dineshannayya/8bit_dac/docs/source/_static/8bit_DAC_Implementation.pptx

Switch

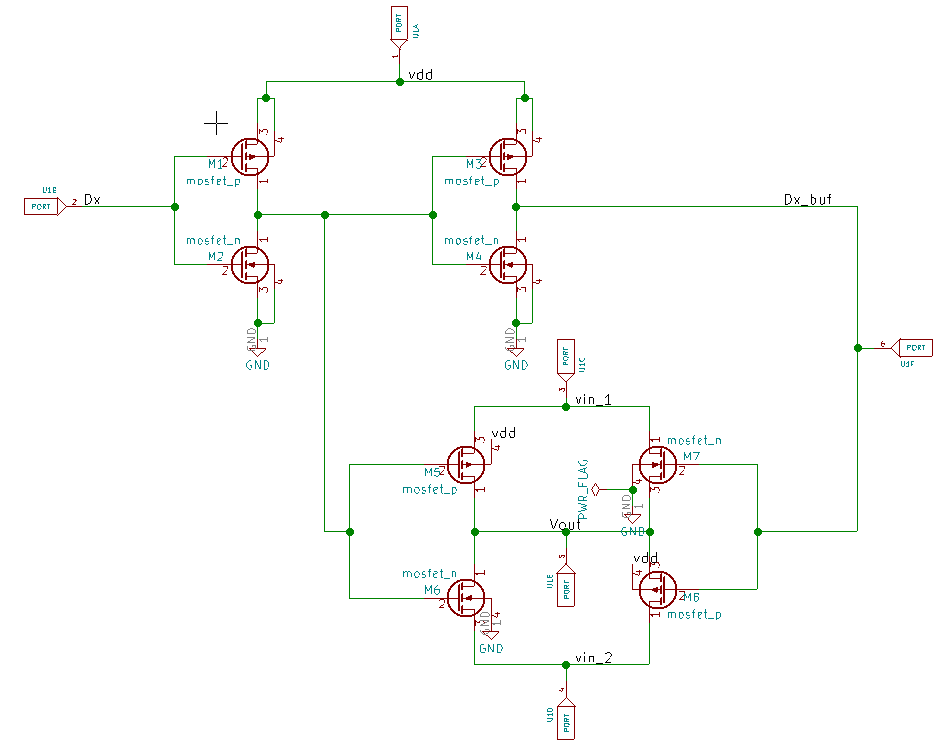
[picture p12: figure]

## Slide 2

Switch 2n

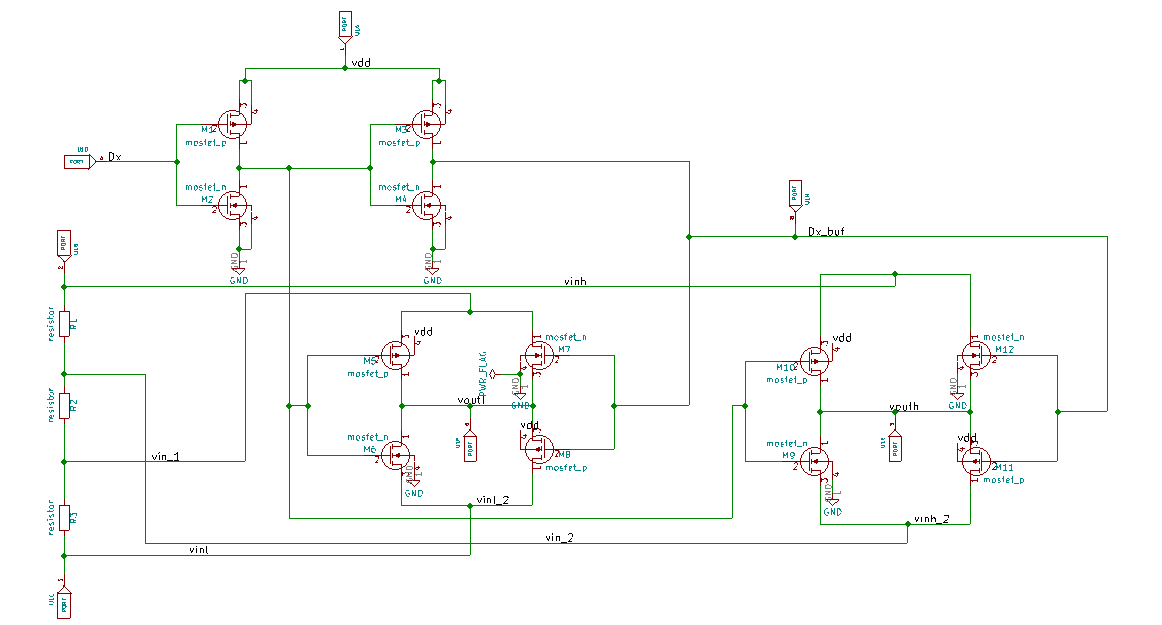
[picture p13: figure]

## Slide 3

2bit DAC

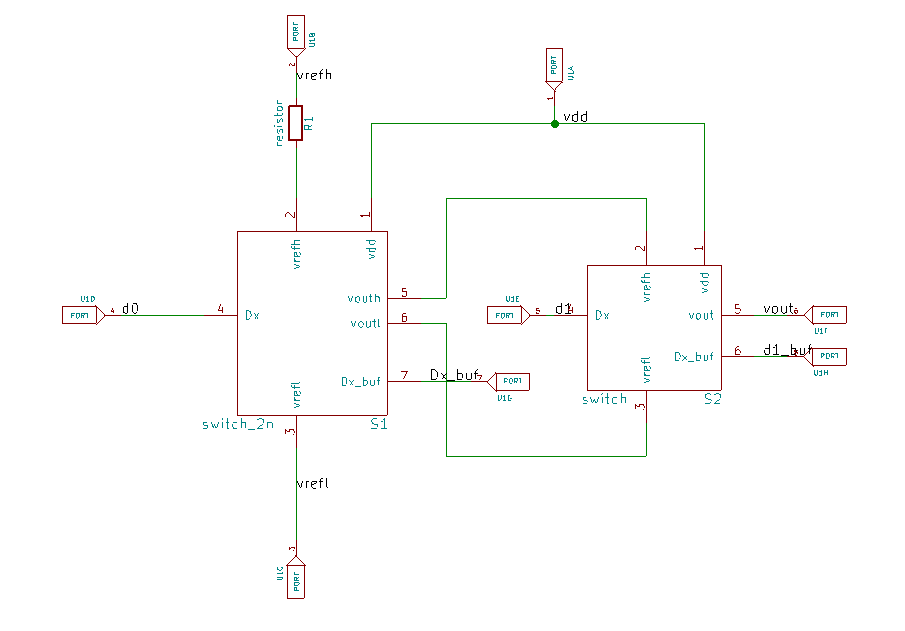
[picture p14: figure]

## Slide 4

3 bit DAC

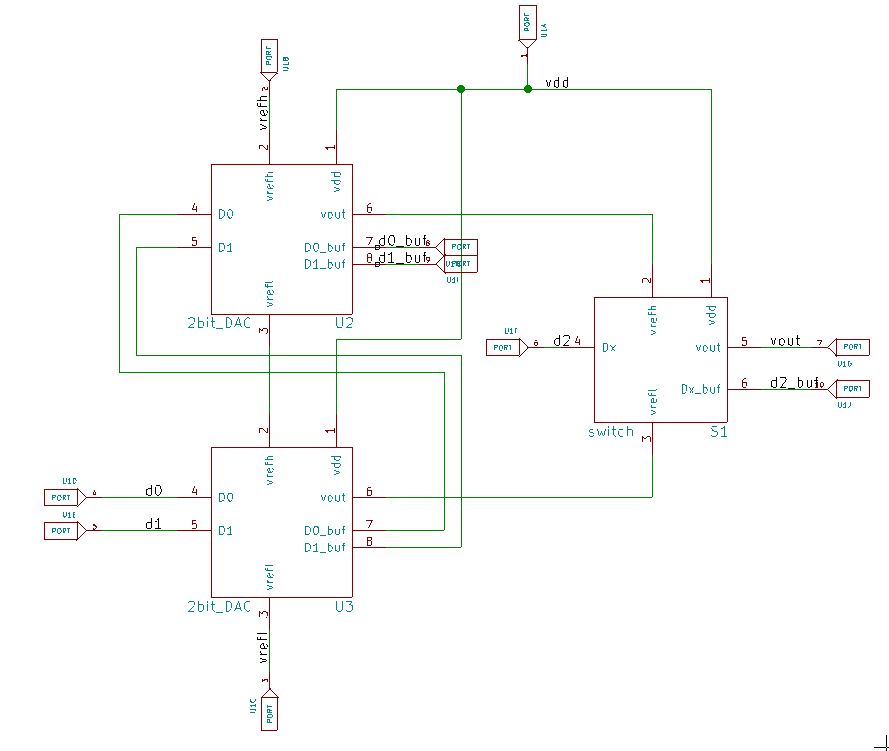
[picture p15: figure]

## Slide 5

4 bit DAC

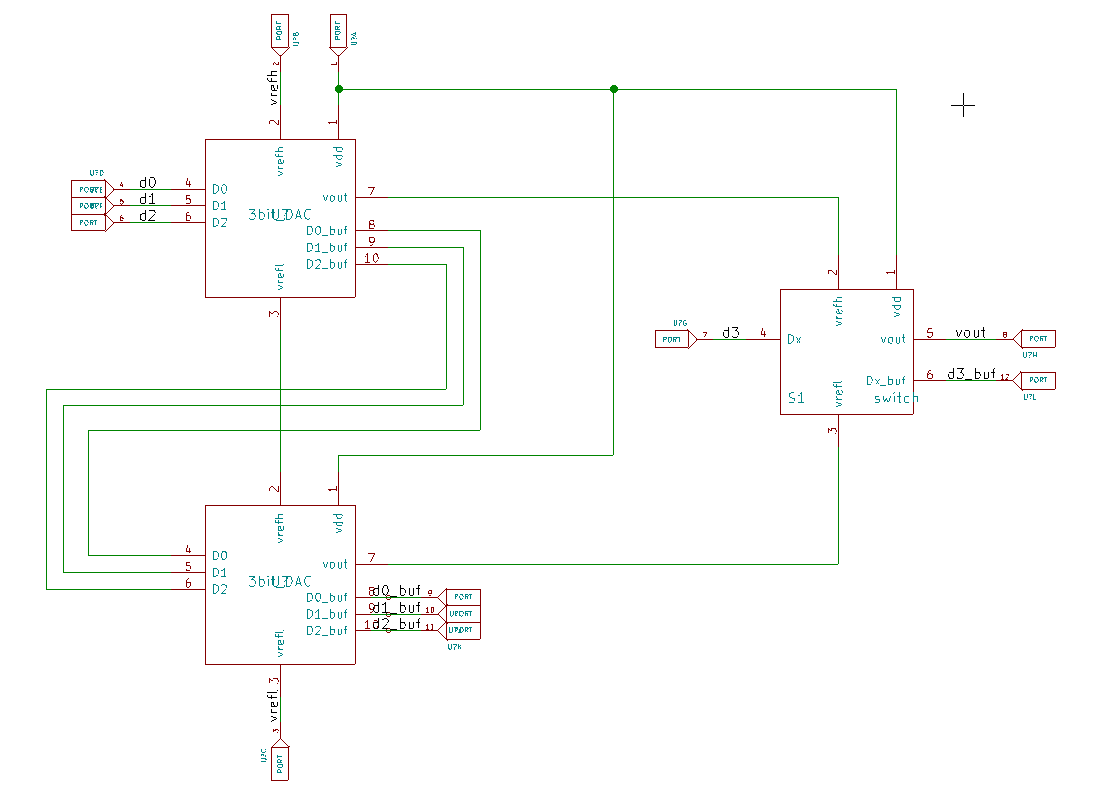
[picture p16: figure]
