dineshannayya/8bit_dac/schematics/switch_2n/switch_2n.cir

* /home/dinesha/workarea/opencore/git/8bit_dac/schematics/switch_2n/switch_2n.cir

* EESchema Netlist Version 1.1 (Spice format) creation date: Sun 30 Apr 2023 10:32:47 PM IST

* To exclude a component from the Spice Netlist add [Spice_Netlist_Enabled] user FIELD set to: N
* To reorder the component spice node sequence add [Spice_Node_Sequence] user FIELD and define sequence: 2,1,0

* Sheet Name: /
M3  /Dx_buf Net-_M1-Pad1_ /vdd /vdd mosfet_p		
M4  /Dx_buf Net-_M1-Pad1_ GND GND mosfet_n		
M1  Net-_M1-Pad1_ /Dx /vdd /vdd mosfet_p		
M2  Net-_M1-Pad1_ /Dx GND GND mosfet_n		
M6  /voutl Net-_M1-Pad1_ /vinl GND mosfet_n		
M5  /voutl Net-_M1-Pad1_ /vin_1 /vdd mosfet_p		
M7  /vin_1 /Dx_buf /voutl GND mosfet_n		
M8  /vinl /Dx_buf /voutl /vdd mosfet_p		
U1  /vdd /vinh /vinl /Dx /vouth /voutl /Dx_buf PORT		
M10  /vouth Net-_M1-Pad1_ /vinh /vdd mosfet_p		
M11  /vin_2 /Dx_buf /vouth /vdd mosfet_p		
M9  /vouth Net-_M1-Pad1_ /vin_2 GND mosfet_n		
M12  /vinh /Dx_buf /vouth GND mosfet_n		
R1  /vinh /vin_2 resistor		
R2  /vin_2 /vin_1 resistor		
R3  /vin_1 /vinl resistor		

.end
