dineshannayya/8bit_dac/eSimLibrary/2bit_DAC/2bit_DAC.sch

## KiCad design eSimLibrary/2bit_DAC/2bit_DAC.sch (2023-04-30)

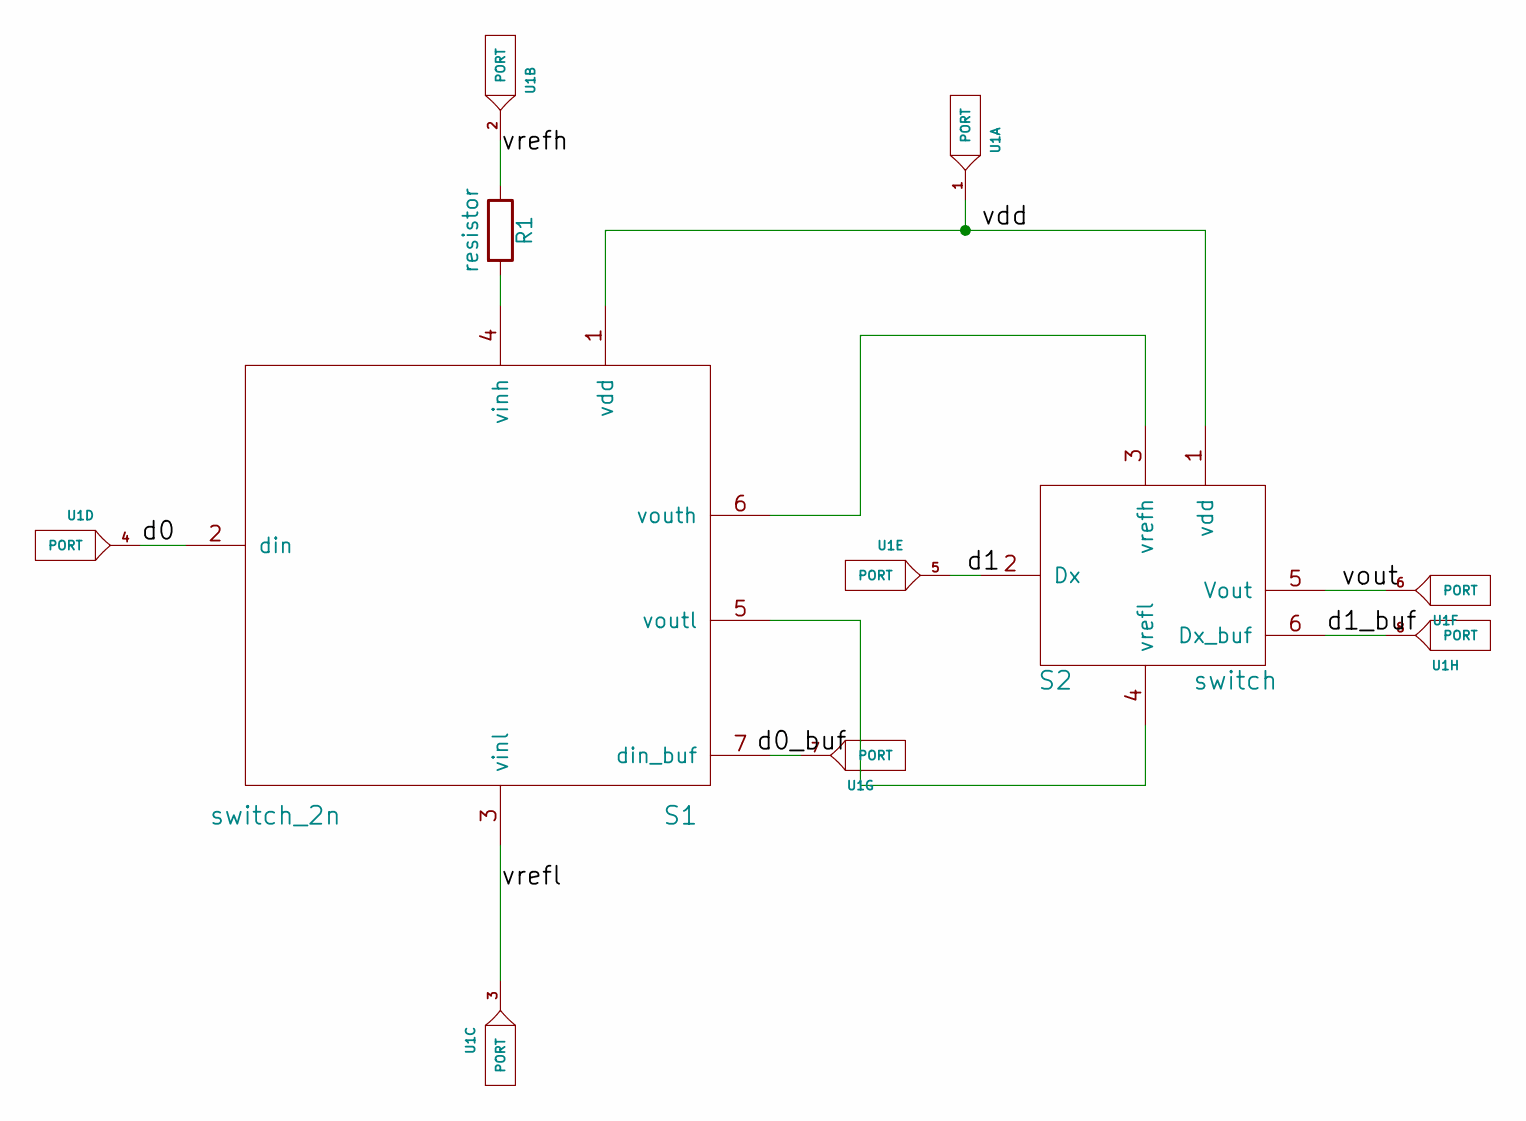
[picture p17: schematic 2bit_DAC.sch]

Parts:
R1: resistor
S1: switch_2n
S2: switch
U1: PORT

Connections:
unnamed: R1.2, S1.4 (vinh)
unnamed: S1.5 (voutl), S2.4 (vrefl)
unnamed: S1.6 (vouth), S2.3 (vrefh)
unnamed: S1.7 (din_buf), U1.7
d0: S1.2 (din), U1.4
d1: S2.2 (Dx), U1.5
d1_buf: S2.6 (Dx_buf), U1.8
vdd: S1.1 (vdd), S2.1 (vdd), U1.1
vout: S2.5 (Vout), U1.6
vrefh: R1.1, U1.2
vrefl: S1.3 (vinl), U1.3
