dineshannayya/8bit_dac/eSimLibrary/3bit_DAC/3bit_DAC.sch

## KiCad design eSimLibrary/3bit_DAC/3bit_DAC.sch (2023-04-30)

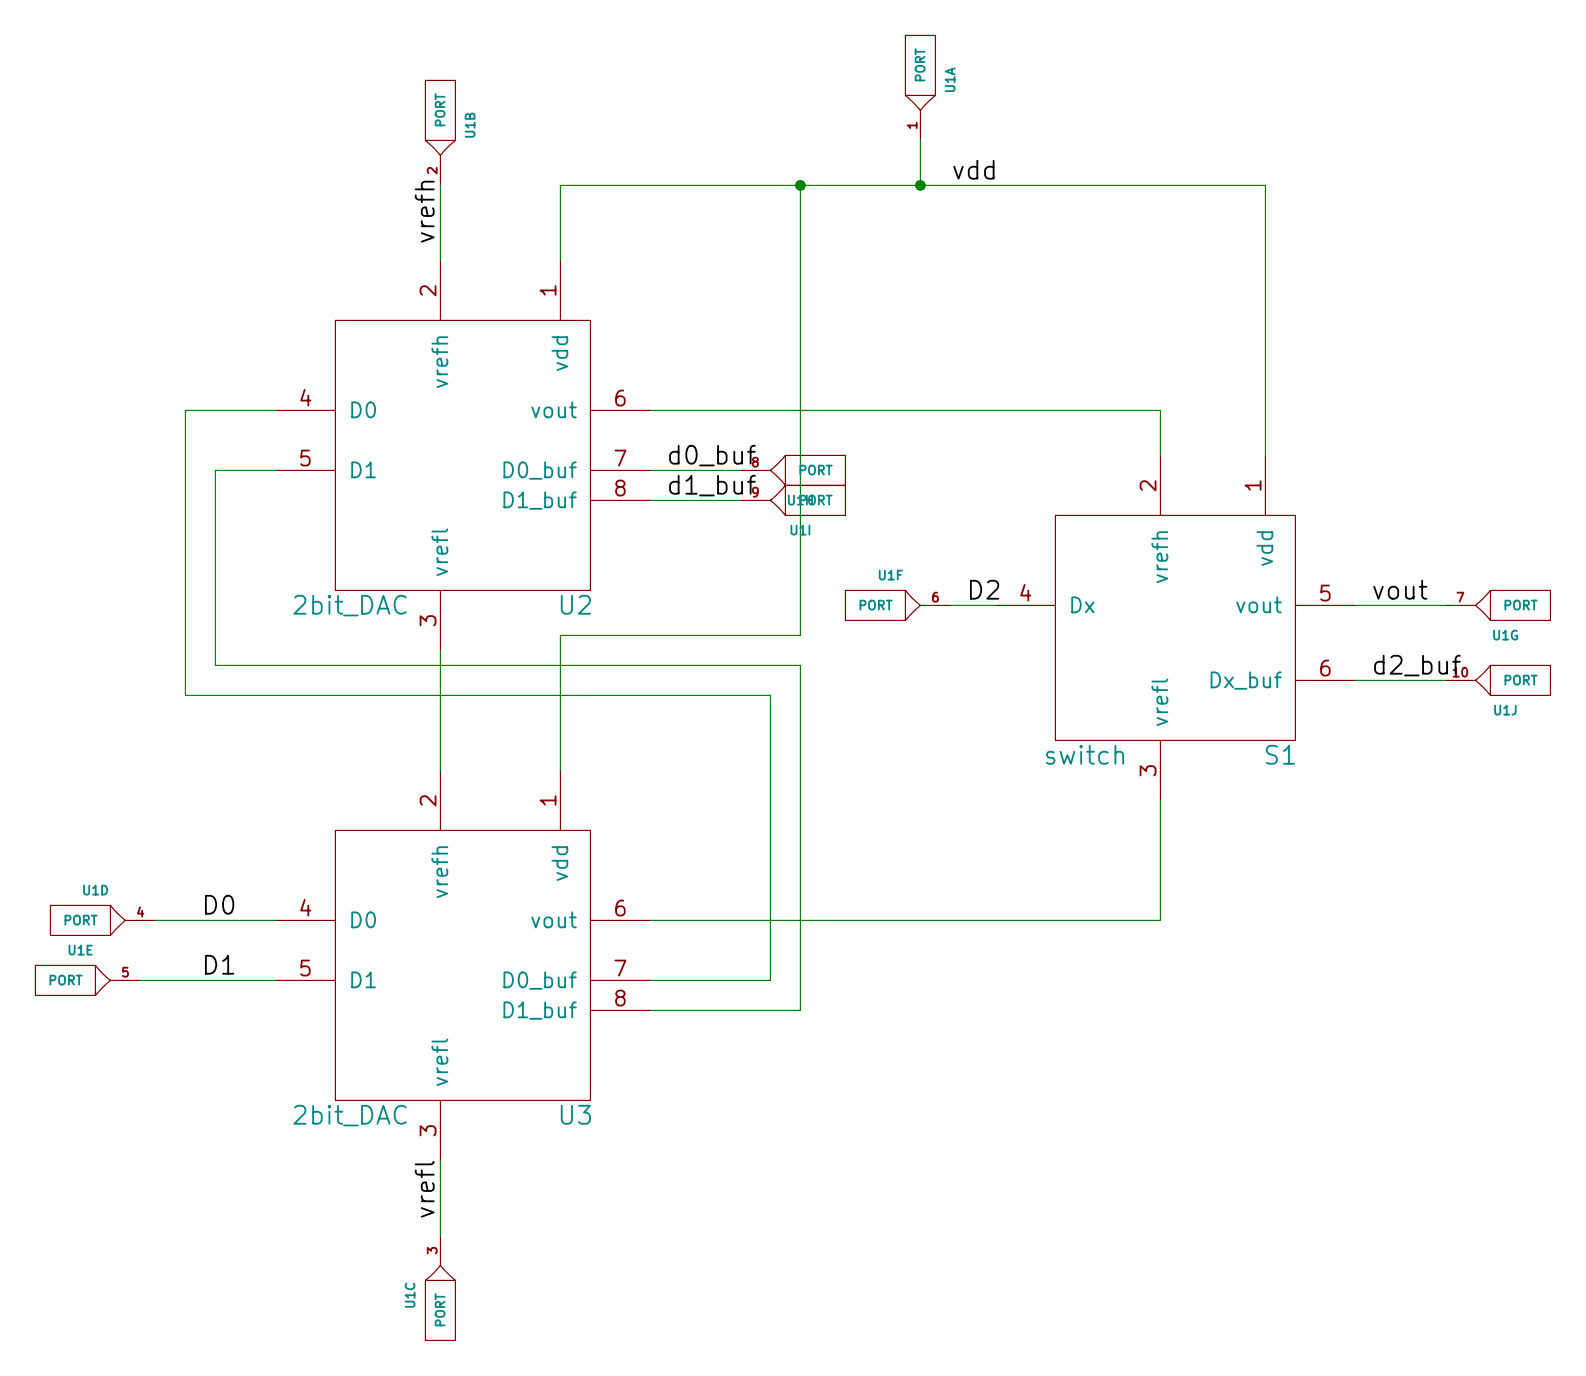
[picture p18: schematic 3bit_DAC.sch]

Parts:
S1: switch
U1: PORT
U2, U3: 2bit_DAC

Connections:
D0: U1.4, U3.4 (D0)
D1: U1.5, U3.5 (D1)
D2: S1.4 (Dx), U1.6
unnamed: S1.2 (vrefh), U2.6 (vout)
unnamed: S1.3 (vrefl), U3.6 (vout)
unnamed: U2.3 (vrefl), U3.2 (vrefh)
unnamed: U2.4 (D0), U3.7 (D0_buf)
unnamed: U2.5 (D1), U3.8 (D1_buf)
d0_buf: U1.8, U2.7 (D0_buf)
d1_buf: U1.9, U2.8 (D1_buf)
d2_buf: S1.6 (Dx_buf), U1.10
vdd: S1.1 (vdd), U1.1, U2.1 (vdd), U3.1 (vdd)
vout: S1.5 (vout), U1.7
vrefh: U1.2, U2.2 (vrefh)
vrefl: U1.3, U3.3 (vrefl)
