dineshannayya/8bit_dac/eSimLibrary/4bit_DAC/4bit_DAC.sch

## KiCad design eSimLibrary/4bit_DAC/4bit_DAC.sch (2023-04-30)

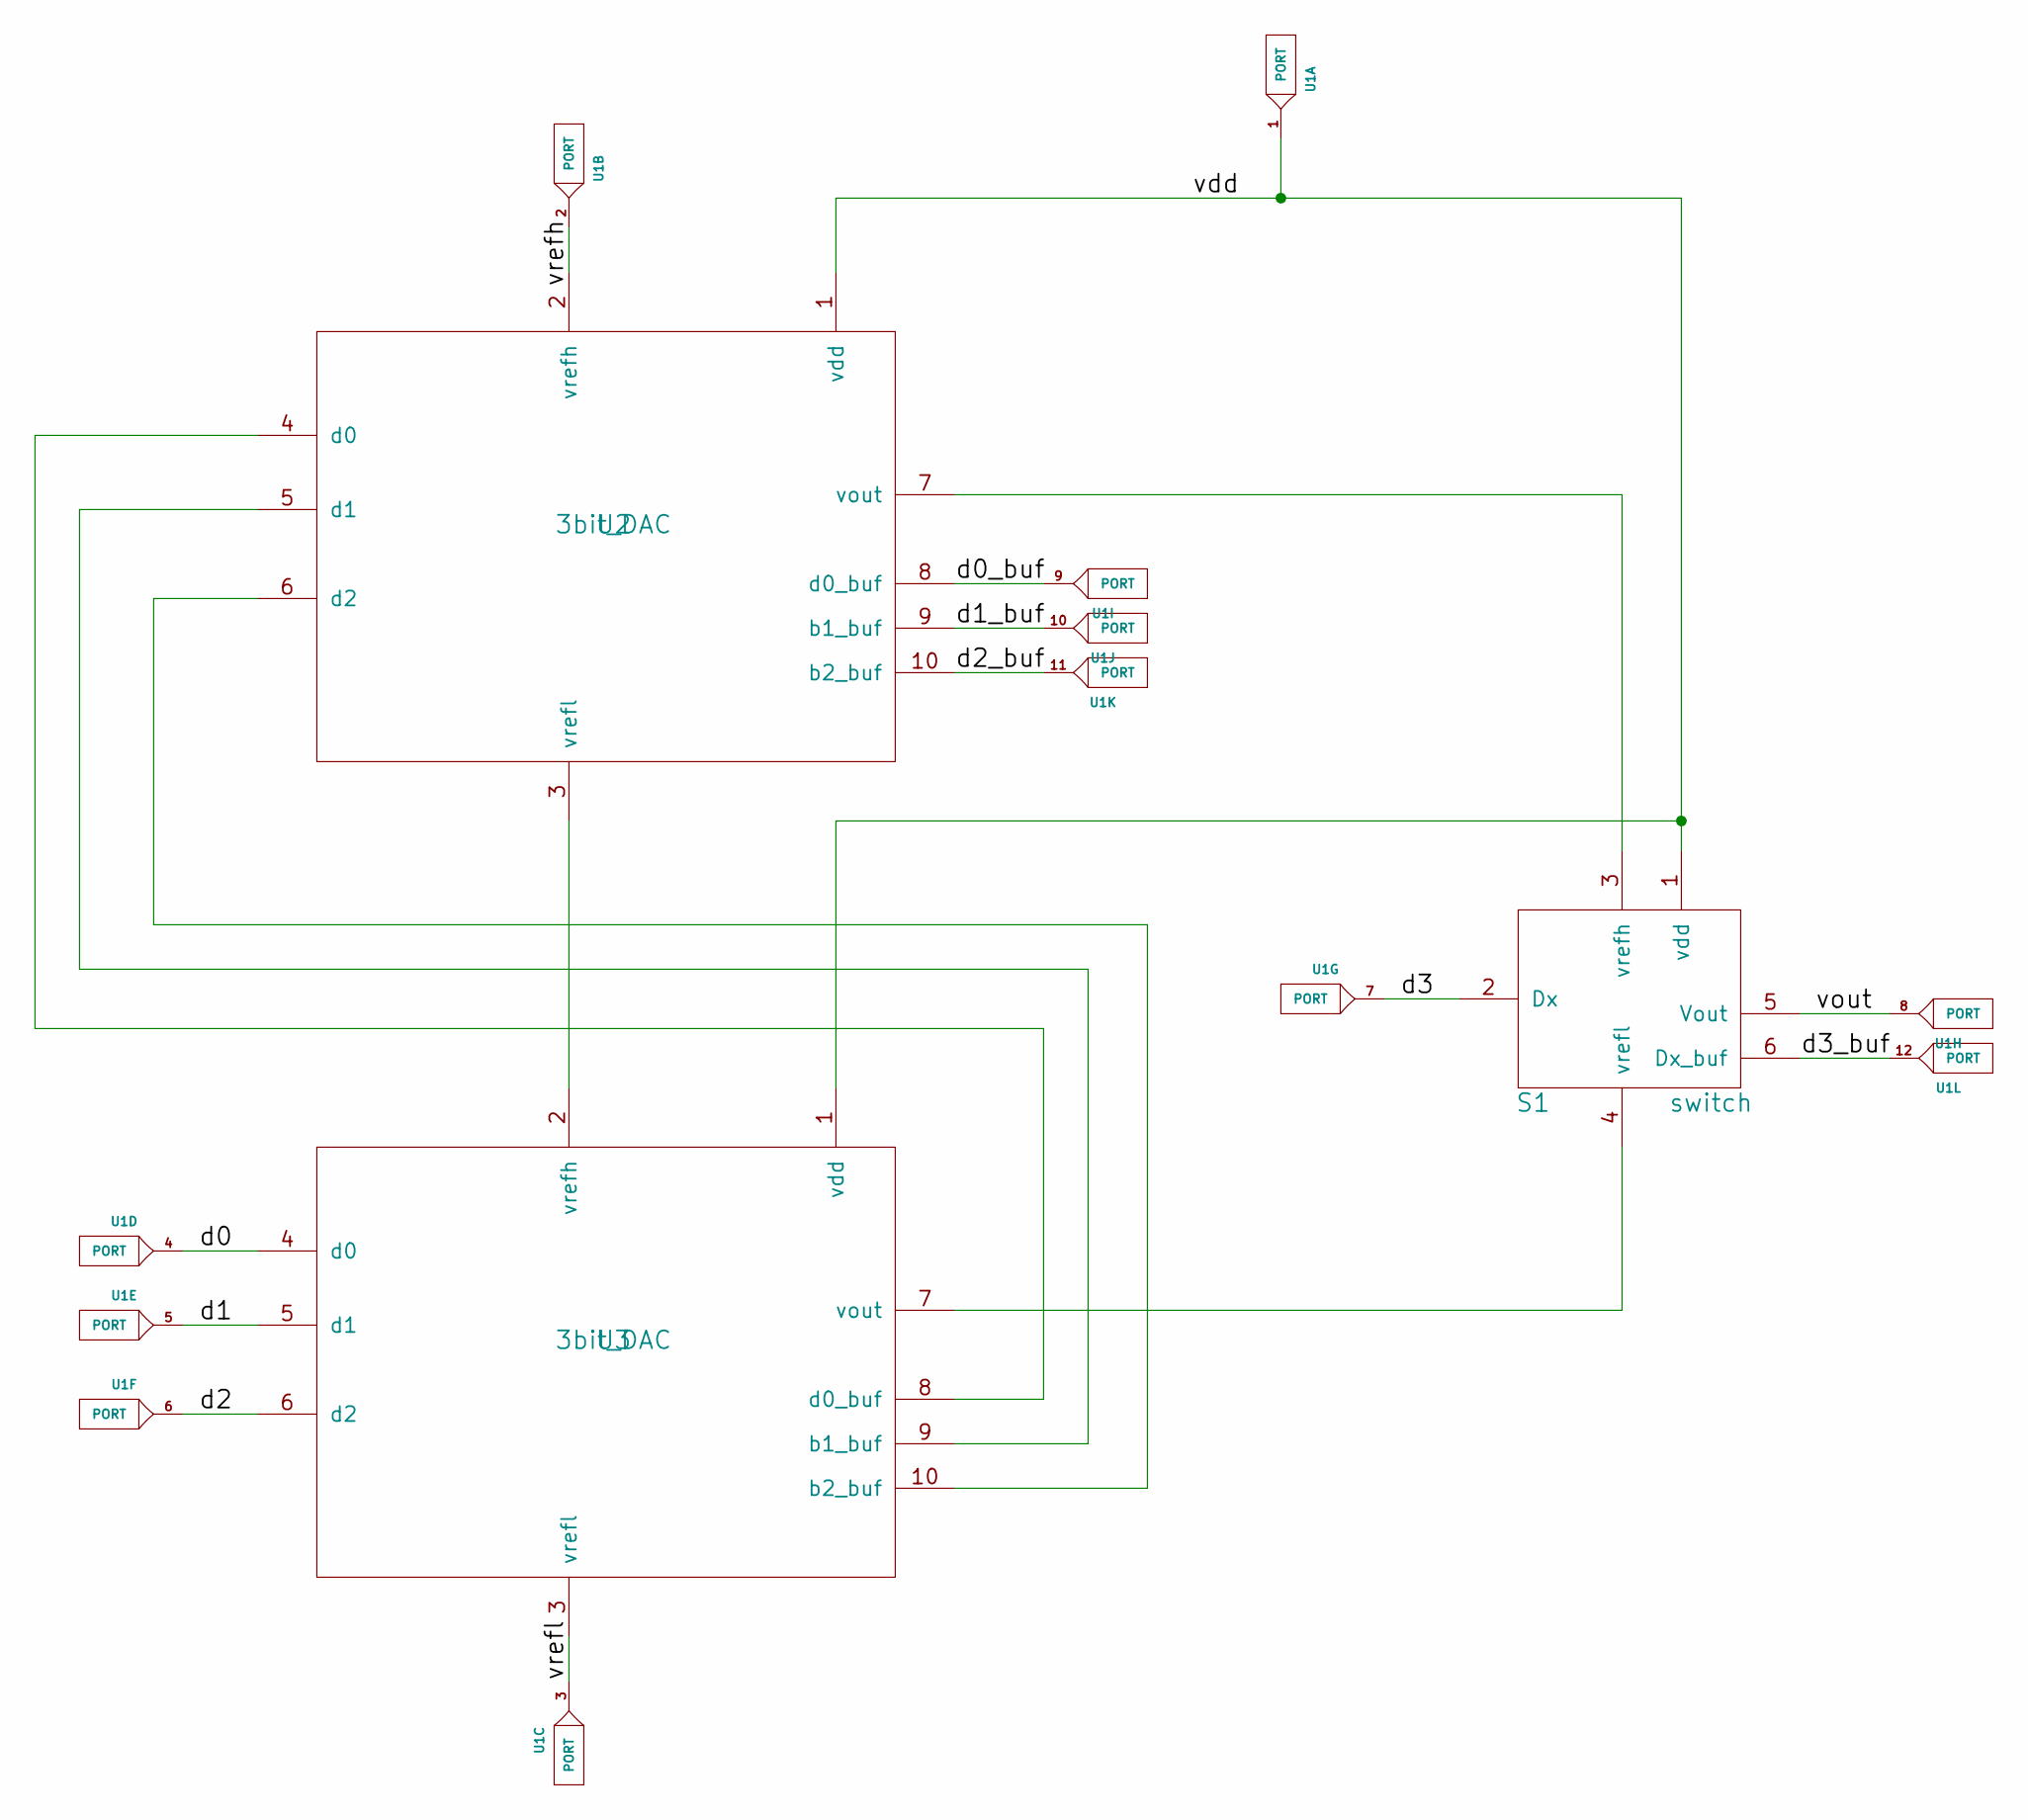
[picture p19: schematic 4bit_DAC.sch]

Parts:
S1: switch
U1: PORT
U2, U3: 3bit_DAC

Connections:
unnamed: S1.3 (vrefh), U2.7 (vout)
unnamed: S1.4 (vrefl), U3.7 (vout)
unnamed: U1.2, U2.2 (vrefh)
unnamed: U2.3 (vrefl), U3.2 (vrefh)
unnamed: U2.4 (d0), U3.8 (d0_buf)
unnamed: U2.5 (d1), U3.9 (b1_buf)
unnamed: U2.6 (d2), U3.10 (b2_buf)
d0: U1.4, U3.4 (d0)
d0_buf: U1.9, U2.8 (d0_buf)
d1: U1.5, U3.5 (d1)
d1_buf: U1.10, U2.9 (b1_buf)
d2: U1.6, U3.6 (d2)
d2_buf: U1.11, U2.10 (b2_buf)
d3: S1.2 (Dx), U1.7
d3_buf: S1.6 (Dx_buf), U1.12
vdd: S1.1 (vdd), U1.1, U2.1 (vdd), U3.1 (vdd)
vout: S1.5 (Vout), U1.8
vrefl: U1.3, U3.3 (vrefl)
