dineshannayya/8bit_dac/eSimLibrary/5bit_DAC/5bit_DAC.sch

## KiCad design eSimLibrary/5bit_DAC/5bit_DAC.sch (2023-04-30)

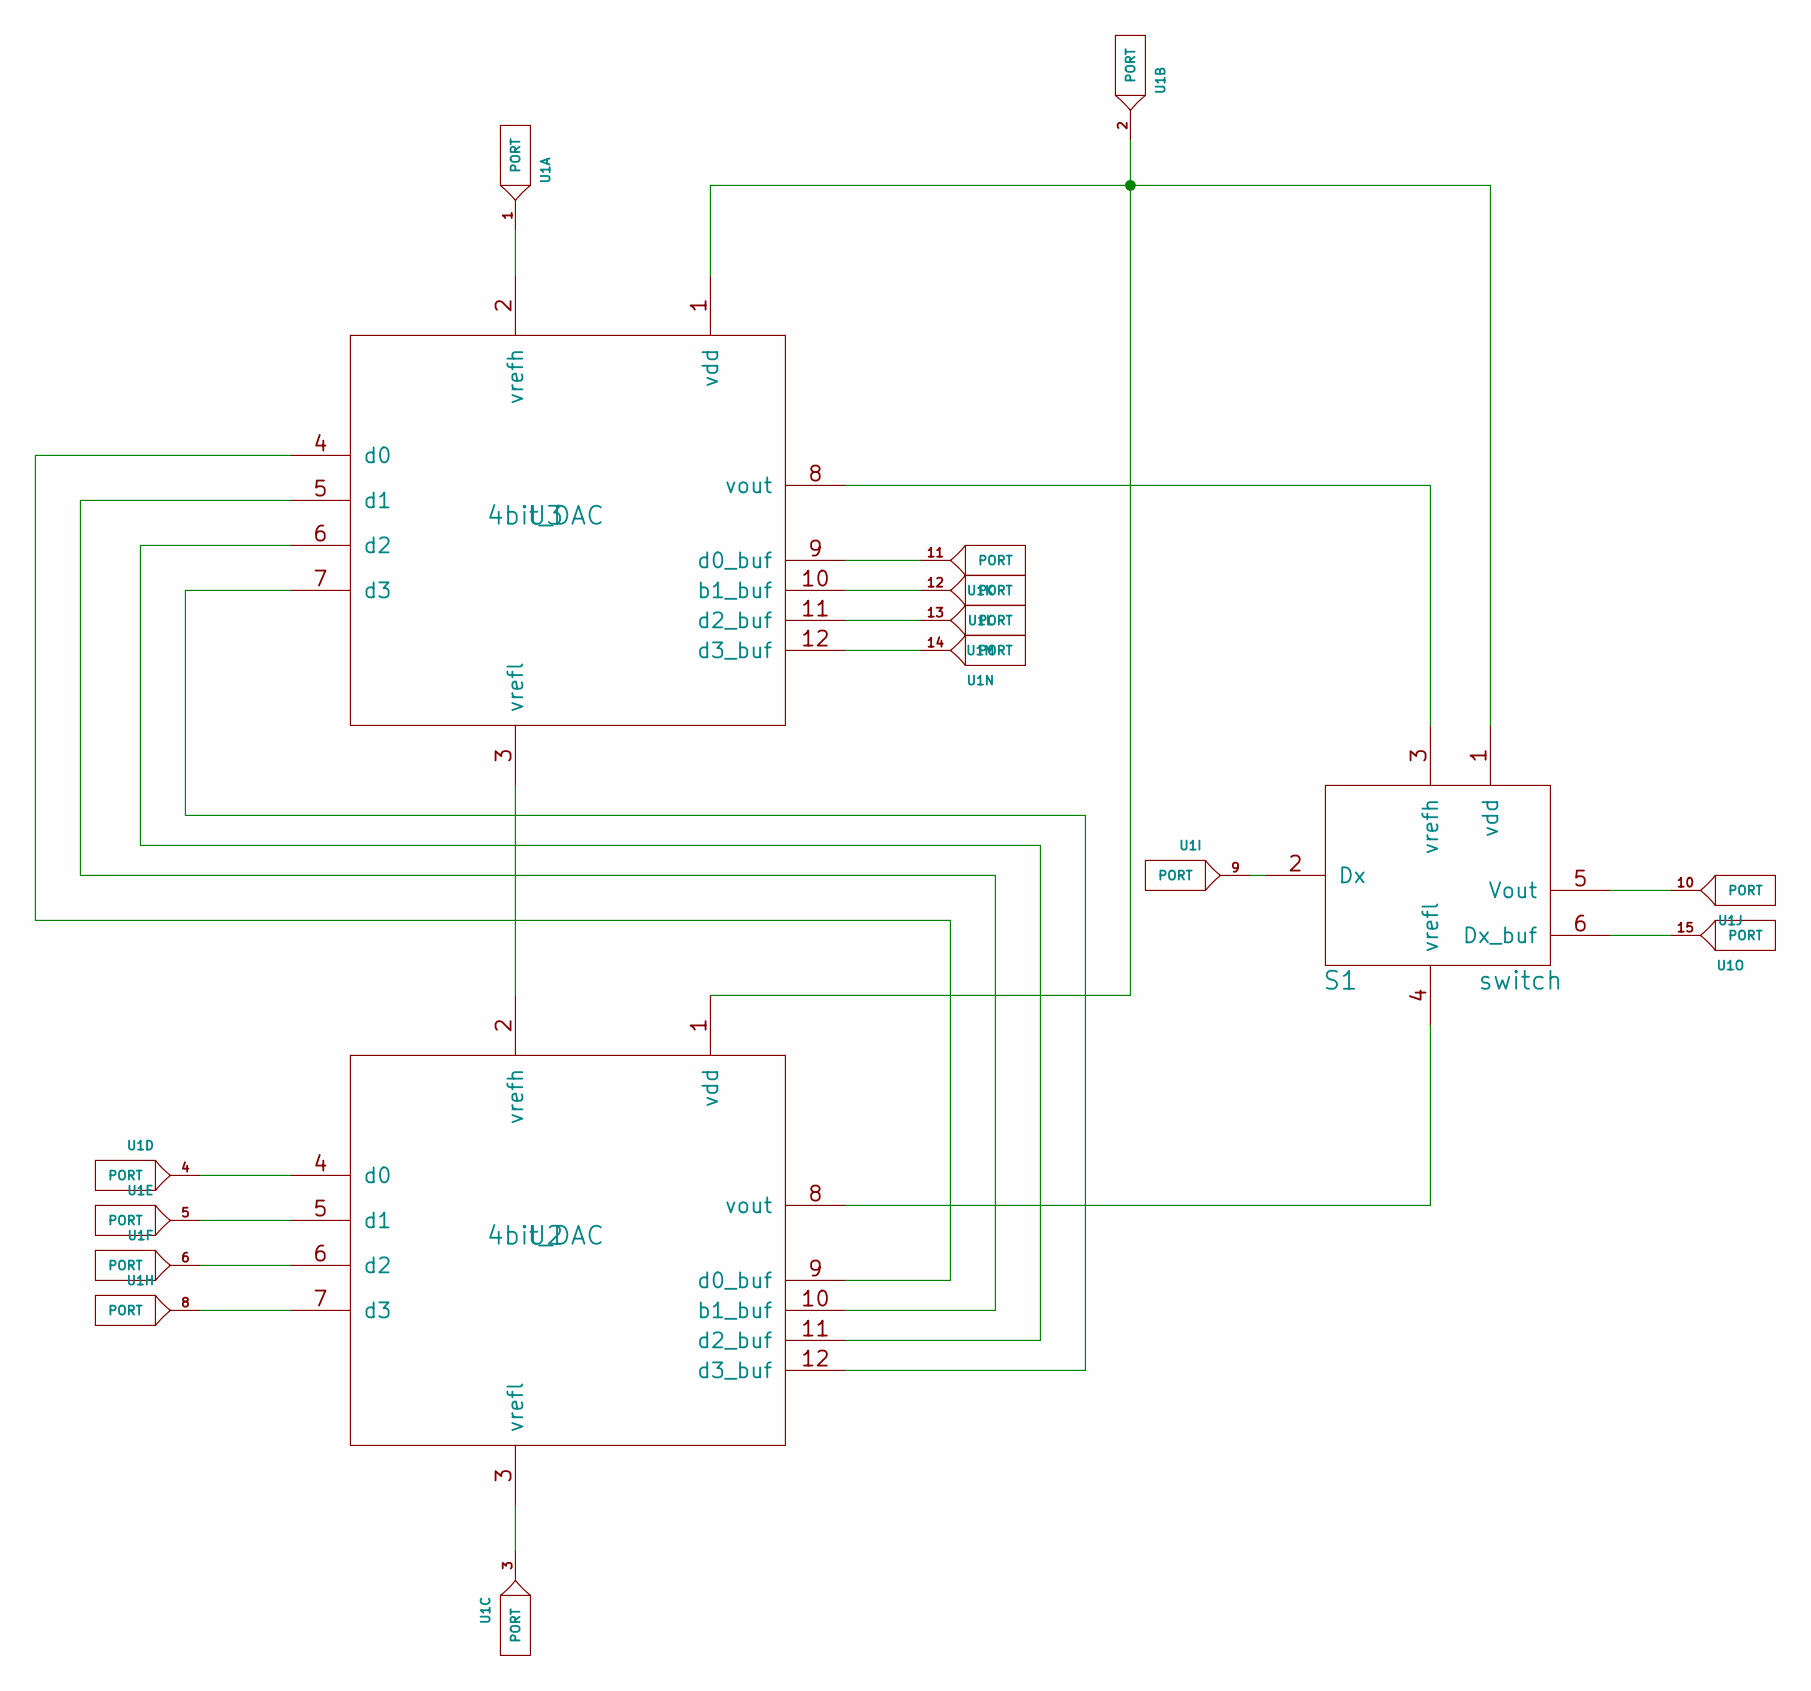
[picture p20: schematic 5bit_DAC.sch]

Parts:
S1: switch
U1: PORT
U2, U3: 4bit_DAC

Connections:
unnamed: S1.1 (vdd), U1.2, U2.1 (vdd), U3.1 (vdd)
unnamed: S1.2 (Dx), U1.9
unnamed: S1.3 (vrefh), U3.8 (vout)
unnamed: S1.4 (vrefl), U2.8 (vout)
unnamed: S1.5 (Vout), U1.10
unnamed: S1.6 (Dx_buf), U1.15
unnamed: U1.1, U3.2 (vrefh)
unnamed: U1.3, U2.3 (vrefl)
unnamed: U1.4, U2.4 (d0)
unnamed: U1.5, U2.5 (d1)
unnamed: U1.6, U2.6 (d2)
unnamed: U1.8, U2.7 (d3)
unnamed: U1.11, U3.9 (d0_buf)
unnamed: U1.12, U3.10 (b1_buf)
unnamed: U1.13, U3.11 (d2_buf)
unnamed: U1.14, U3.12 (d3_buf)
unnamed: U2.2 (vrefh), U3.3 (vrefl)
unnamed: U2.9 (d0_buf), U3.4 (d0)
unnamed: U2.10 (b1_buf), U3.5 (d1)
unnamed: U2.11 (d2_buf), U3.6 (d2)
unnamed: U2.12 (d3_buf), U3.7 (d3)
