dineshannayya/8bit_dac/eSimLibrary/switch/switch.sch

## KiCad design eSimLibrary/switch/switch.sch (2023-04-30)

Schematic: switch.sch

Parts:
M1, M3, M5, M8: mosfet_n
M2, M4, M6, M7: mosfet_p
U1: PORT
