dineshannayya/8bit_dac/schematics/switch/switch2n.sch

## KiCad design schematics/switch/switch2n.sch (2023-04-22)

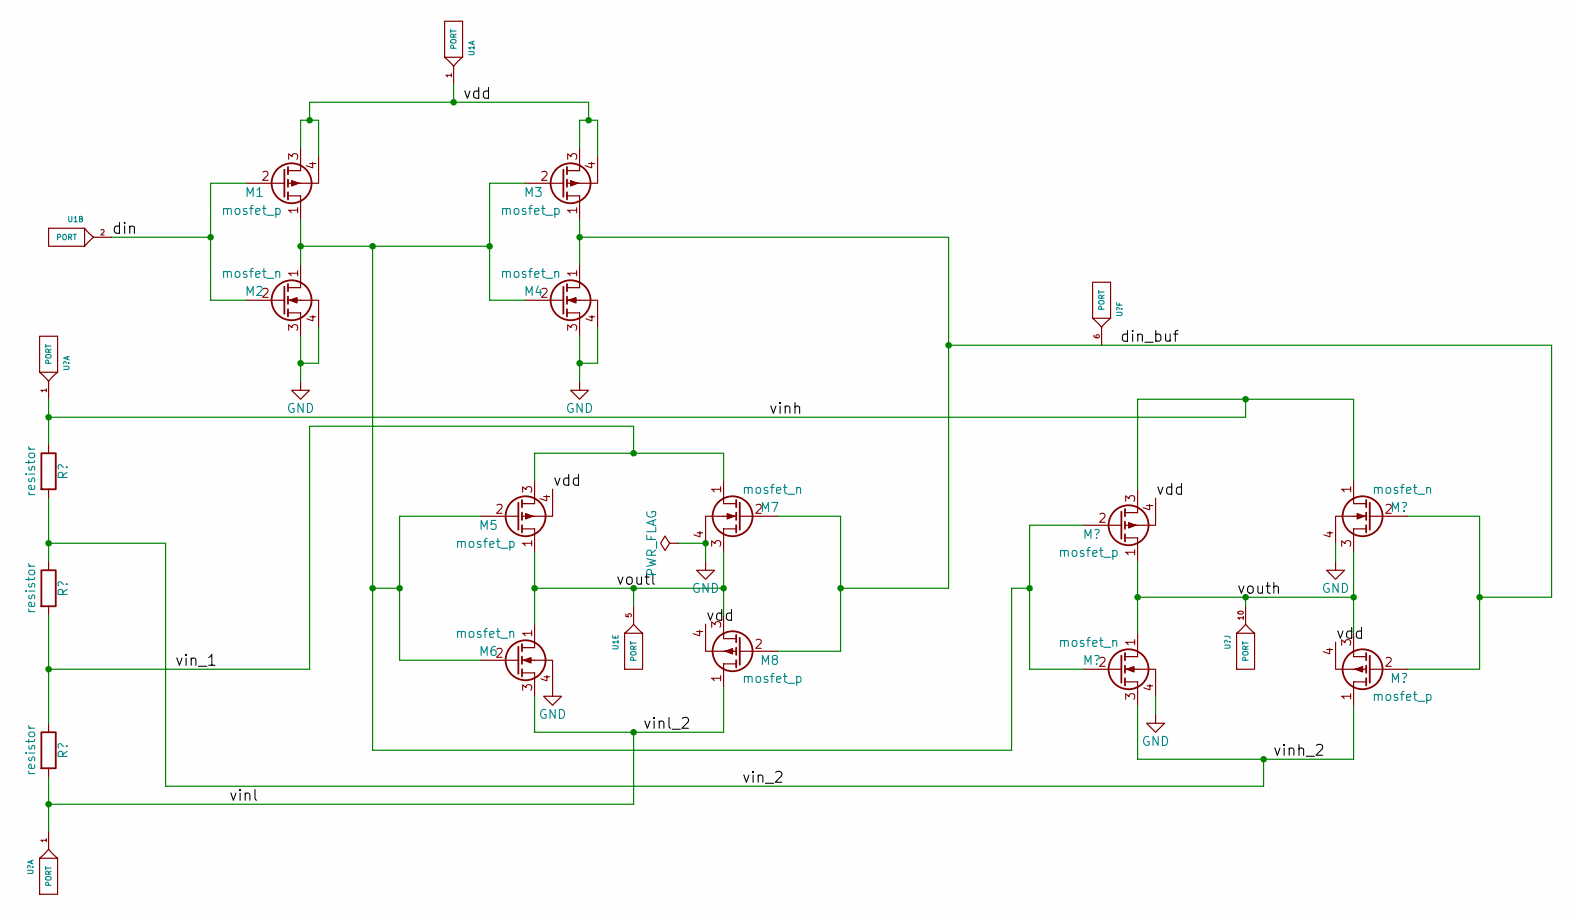
[picture p21: schematic switch2n.sch]

Parts:
M1, M3, M5, M8: mosfet_p
M2, M4, M6, M7: mosfet_n
U1: PORT

Connections:
GND: M2.3 (S), M2.4 (B), M4.3 (S), M4.4 (B), M6.4 (B), M7.4 (B)
unnamed: M1.1 (D), M2.1 (D), M3.2 (G), M4.2 (G), M5.2 (G), M6.2 (G)
din: M1.2 (G), M2.2 (G), U1.2
din_buf: M3.1 (D), M4.1 (D), M7.2 (G), M8.2 (G)
vdd: M1.3 (S), M1.4 (B), M3.3 (S), M3.4 (B), M5.4 (B), M8.4 (B), U1.1
vin_1: M5.3 (S), M7.1 (D)
vinl: M6.3 (S), M8.1 (D)
voutl: M5.1 (D), M6.1 (D), M7.3 (S), M8.3 (S), U1.5
