dineshannayya/8bit_dac/schematics/switch_2n/switch_2n.sch

## KiCad design schematics/switch_2n/switch_2n.sch (2023-04-30)

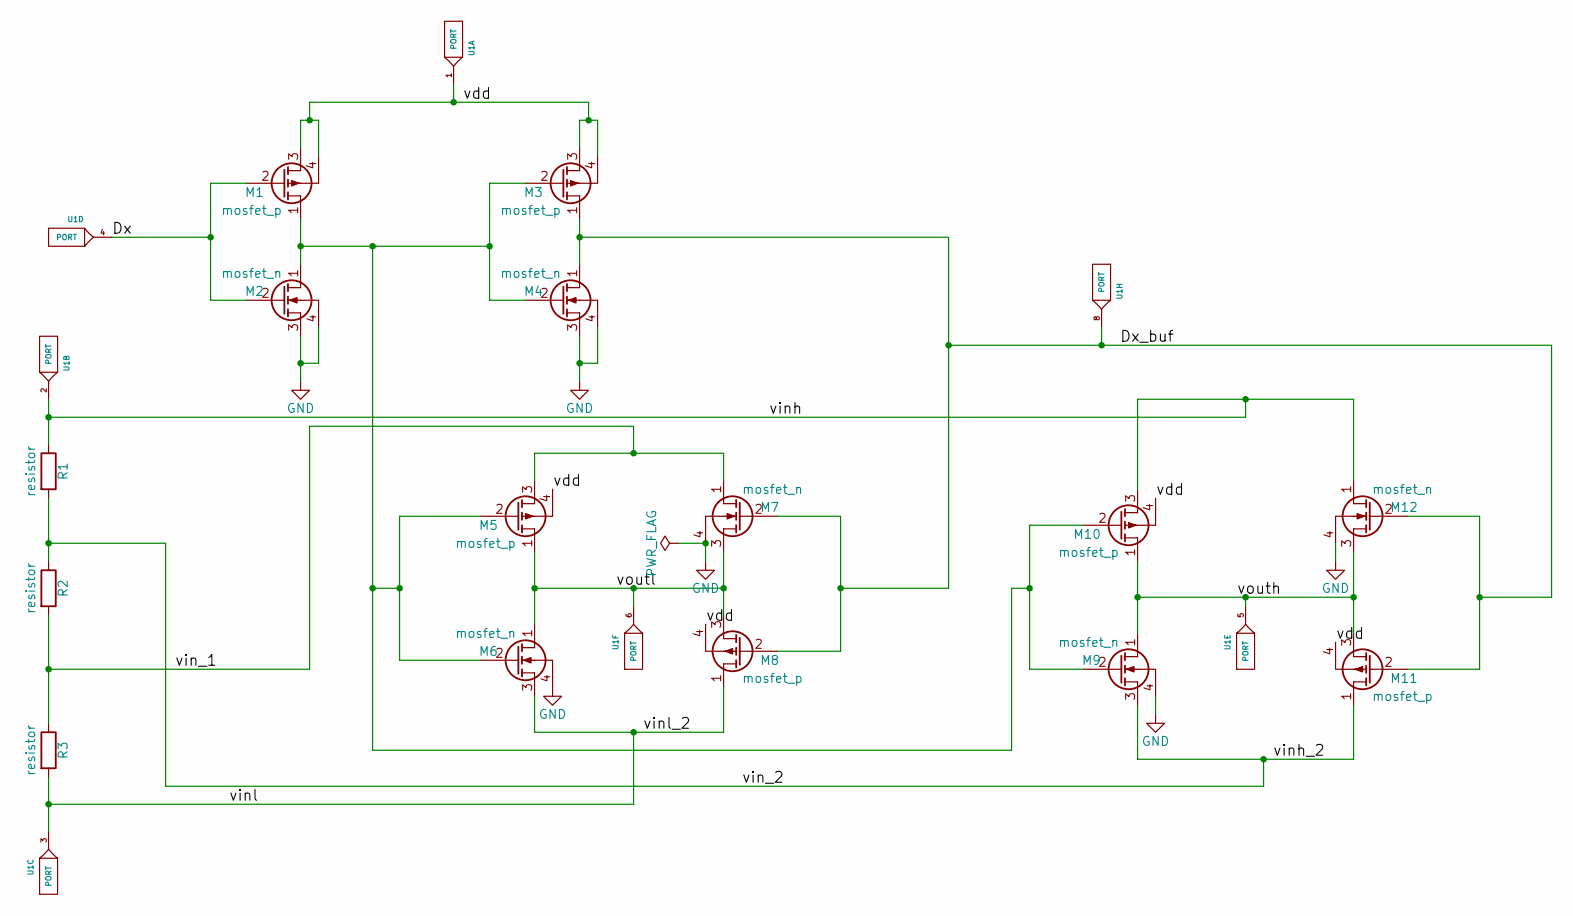
[picture p22: schematic switch_2n.sch]

Parts:
M1, M3, M5, M8, M10, M11: mosfet_p
M2, M4, M6, M7, M9, M12: mosfet_n
R1, R2, R3: resistor
U1: PORT

Connections:
Dx: M1.2 (G), M2.2 (G), U1.4
Dx_buf: M3.1 (D), M4.1 (D), M7.2 (G), M8.2 (G), M11.2 (G), M12.2 (G), U1.8
GND: M2.3 (S), M2.4 (B), M4.3 (S), M4.4 (B), M6.4 (B), M7.4 (B), M9.4 (B), M12.4 (B)
unnamed: M1.1 (D), M2.1 (D), M3.2 (G), M4.2 (G), M5.2 (G), M6.2 (G), M9.2 (G), M10.2 (G)
vdd: M1.3 (S), M1.4 (B), M3.3 (S), M3.4 (B), M5.4 (B), M8.4 (B), M10.4 (B), M11.4 (B), U1.1
vin_1: M5.3 (S), M7.1 (D), R2.2, R3.1
vin_2: M9.3 (S), M11.1 (D), R1.2, R2.1
vinh: M10.3 (S), M12.1 (D), R1.1, U1.2
vinl: M6.3 (S), M8.1 (D), R3.2, U1.3
vouth: M9.1 (D), M10.1 (D), M11.3 (S), M12.3 (S), U1.5
voutl: M5.1 (D), M6.1 (D), M7.3 (S), M8.3 (S), U1.6
