dineshannayya/8bit_dac/(commit log)

2022-09-23 first version
    [pin_order.cfg]
2022-09-29 latest ver1.0 release
    [pin_order.cfg]
